kurone741/tamago/README.md

# tamago

tamago is a simple desktop companion. I built it because I thought it seemed like a good entry point into pcb design, without being unnecessarily complex. 

Functionality includes date/time, timer, stopwatch, countdown, and noise visualizer which responds to the sounds in your working space (e.g. typing/music). It can also display humidity and temperature of your working space. It's a device that is for the most part single-purpose, meaning it doesn't occupy more of your attention than it needs. THis also helps me stay on focus more.

ps. tamago is japanese for egg

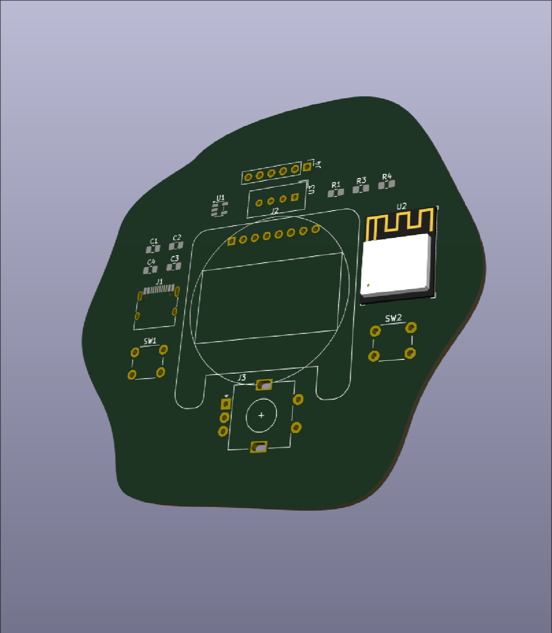
[picture p1: images/tamago-unrouted-pcb-3d.png]
tamago unrouted pcb 3d

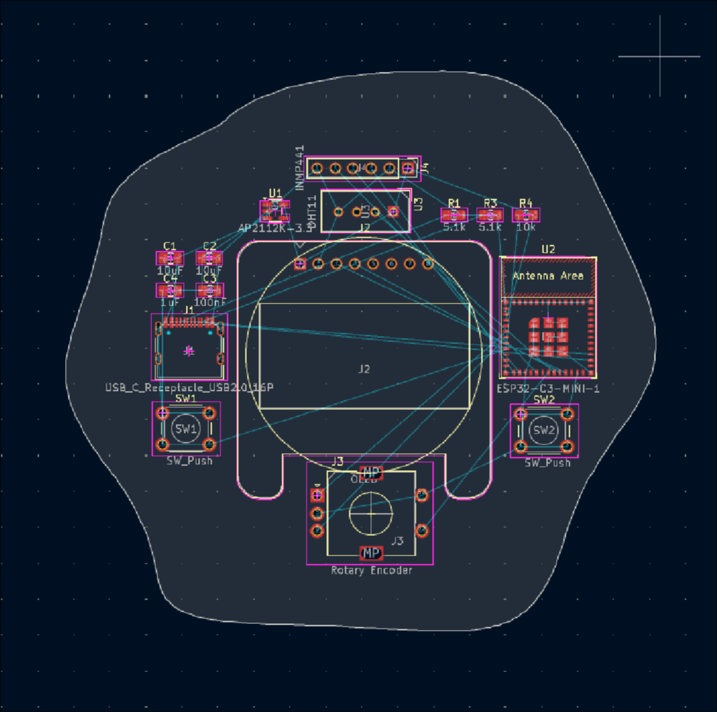
[picture p2: tamago-unrouted-pcb.png]
unrouted pcb diagram

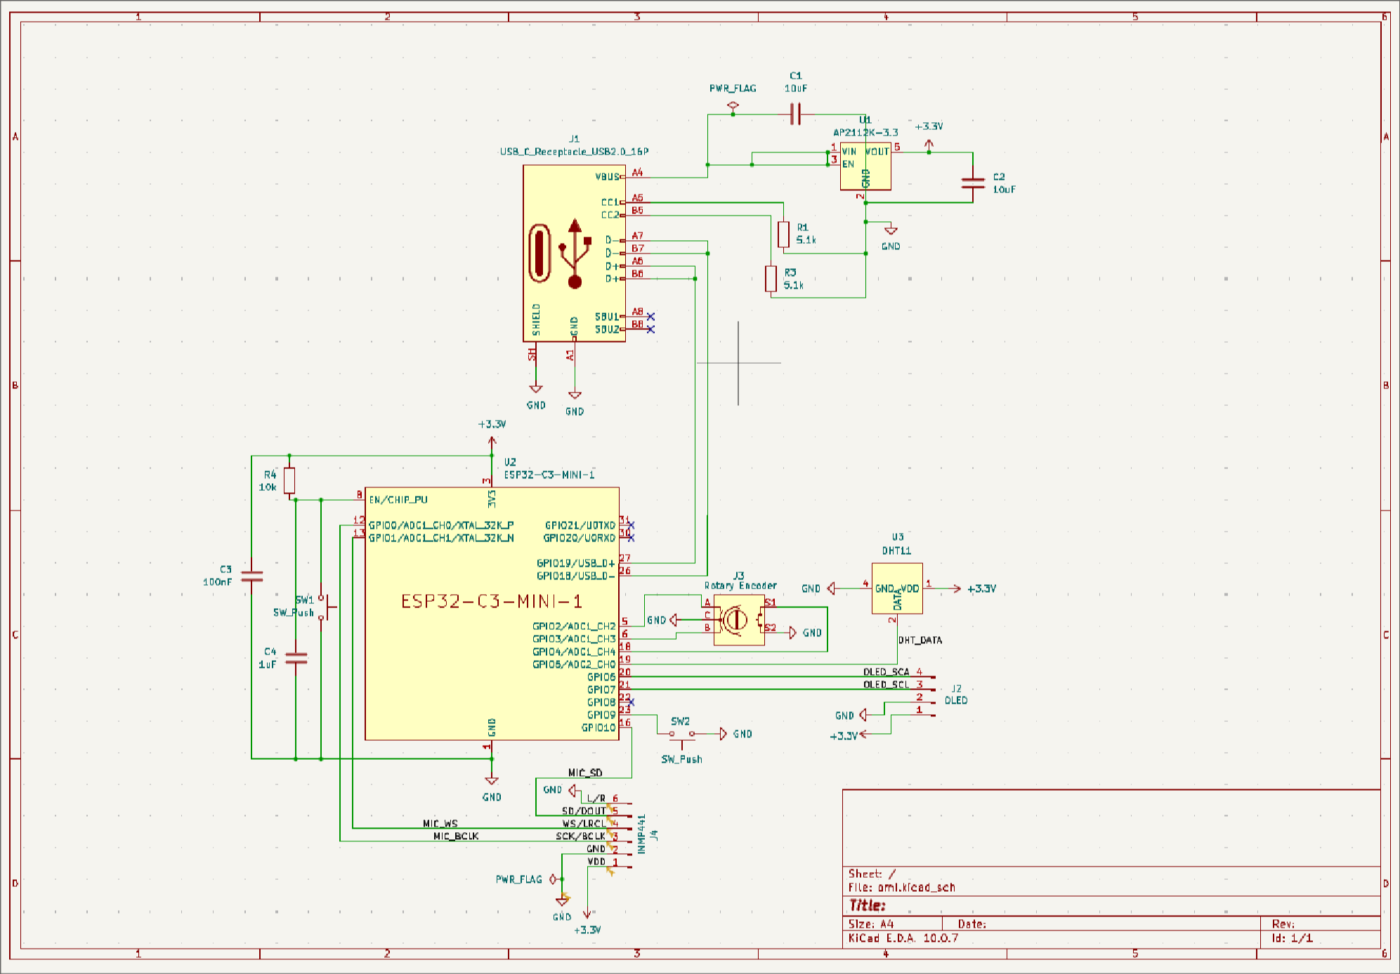
[picture p3: images/tamago-schematic-finished.png]
tamago schematic finished!


## bill of materials
| Item | Qty | Supplier | Cost/item | Total Cost | Link |
|---|---:|---|---:|---:|---|
| ESP32-C3-MINI-1 | 1 | Aliexpress | $4.69 | $4.69 | https://www.aliexpress.com/item/3256810385497528.html |
| 0.96" OLED | 1 | Aliexpress | $1.09 | $1.09 | https://www.aliexpress.com/item/3256810476428595.html |
| EC11 KY-040 Rotary Encoder | 1 | Aliexpress | $2.49 | $2.49 | https://www.aliexpress.com/item/3256812187820082.html |
| DHT11 | 1 | Aliexpress | $2.01 | $2.01 | https://www.aliexpress.com/item/3256808804649487.html |
| INMP441 | 1 | Aliexpress | $2.95 | $2.95 | https://www.aliexpress.com/item/3256809519855925.html |
| Passive Components | 1 | Aliexpress | $12.27 | $12.27 | https://www.aliexpress.us/item/3256803146822180.html |
| PCB | 1 | JLCPCB | $4.00 | $4.00 | https://jlcpcb.com |
| Estimated total shipping | 1 | | | $0.00 | |
