kurone741/tamago/errormessage.png

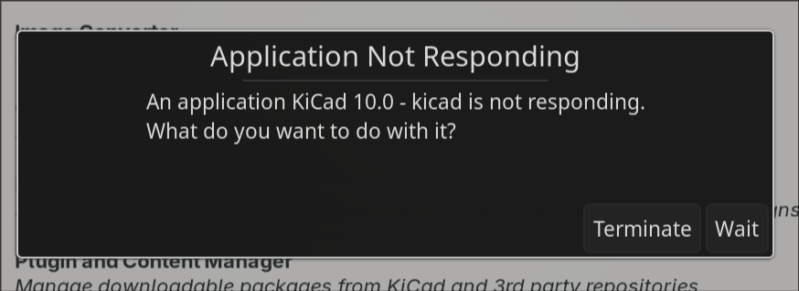
errormessage.png
