kurone741/tamago/finishedp1.png

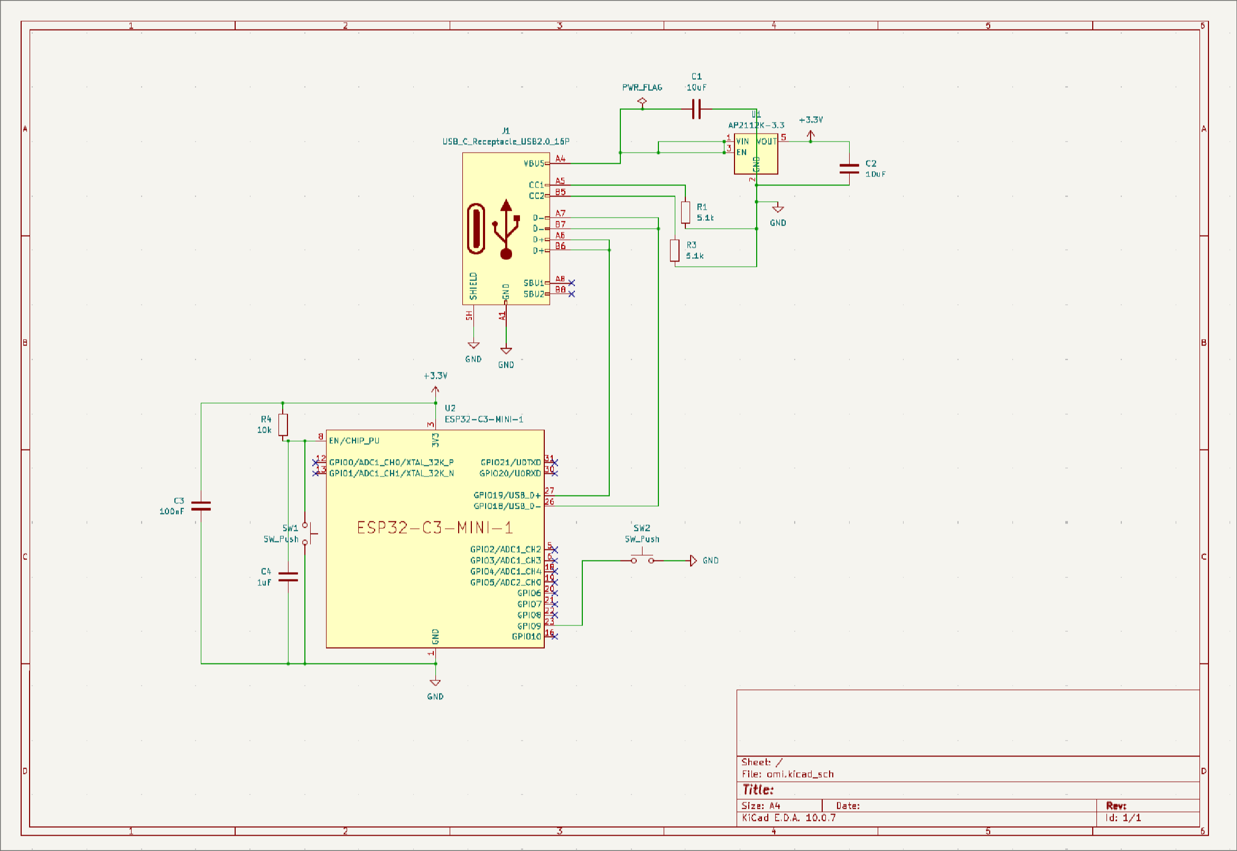
finishedp1.png
