kurone741/tamago/footprints.png

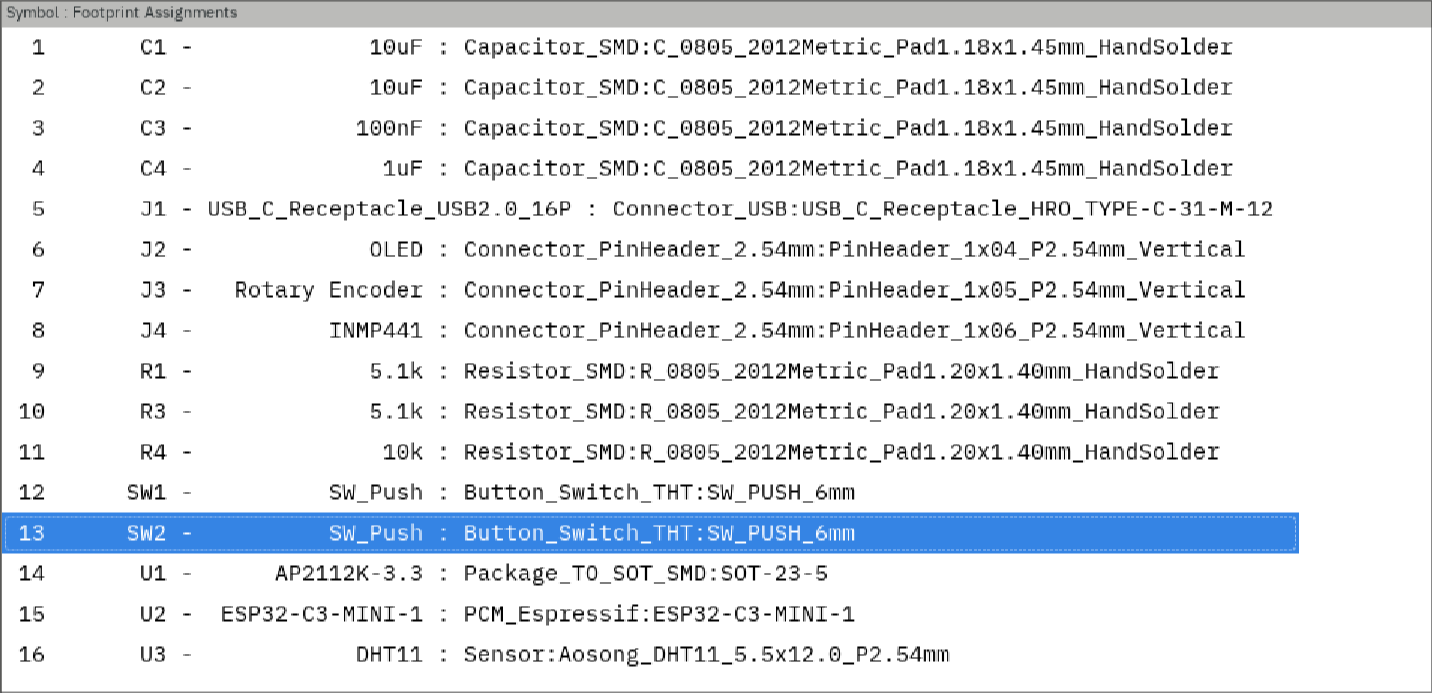
footprints.png
