kurone741/tamago/messy-schematic.png

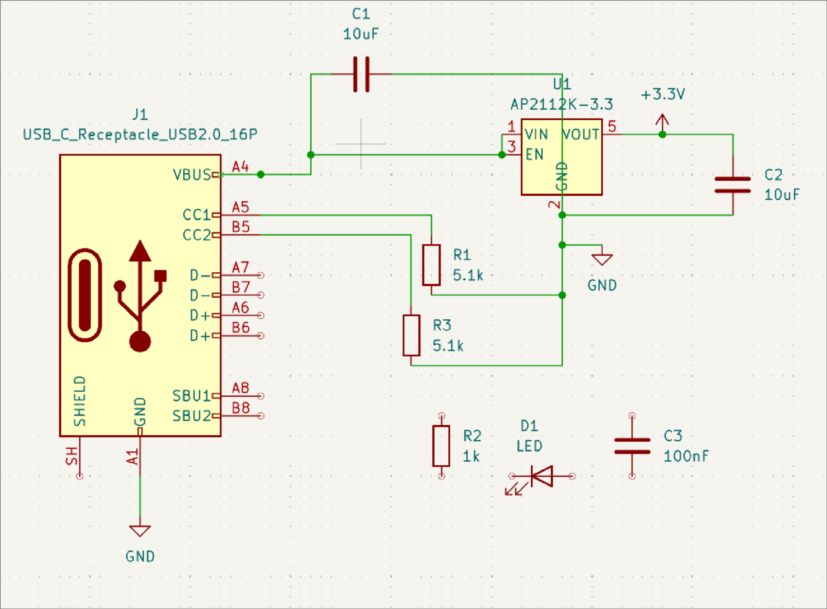
messy-schematic.png
