kurone741/tamago/schematic-tamago.png

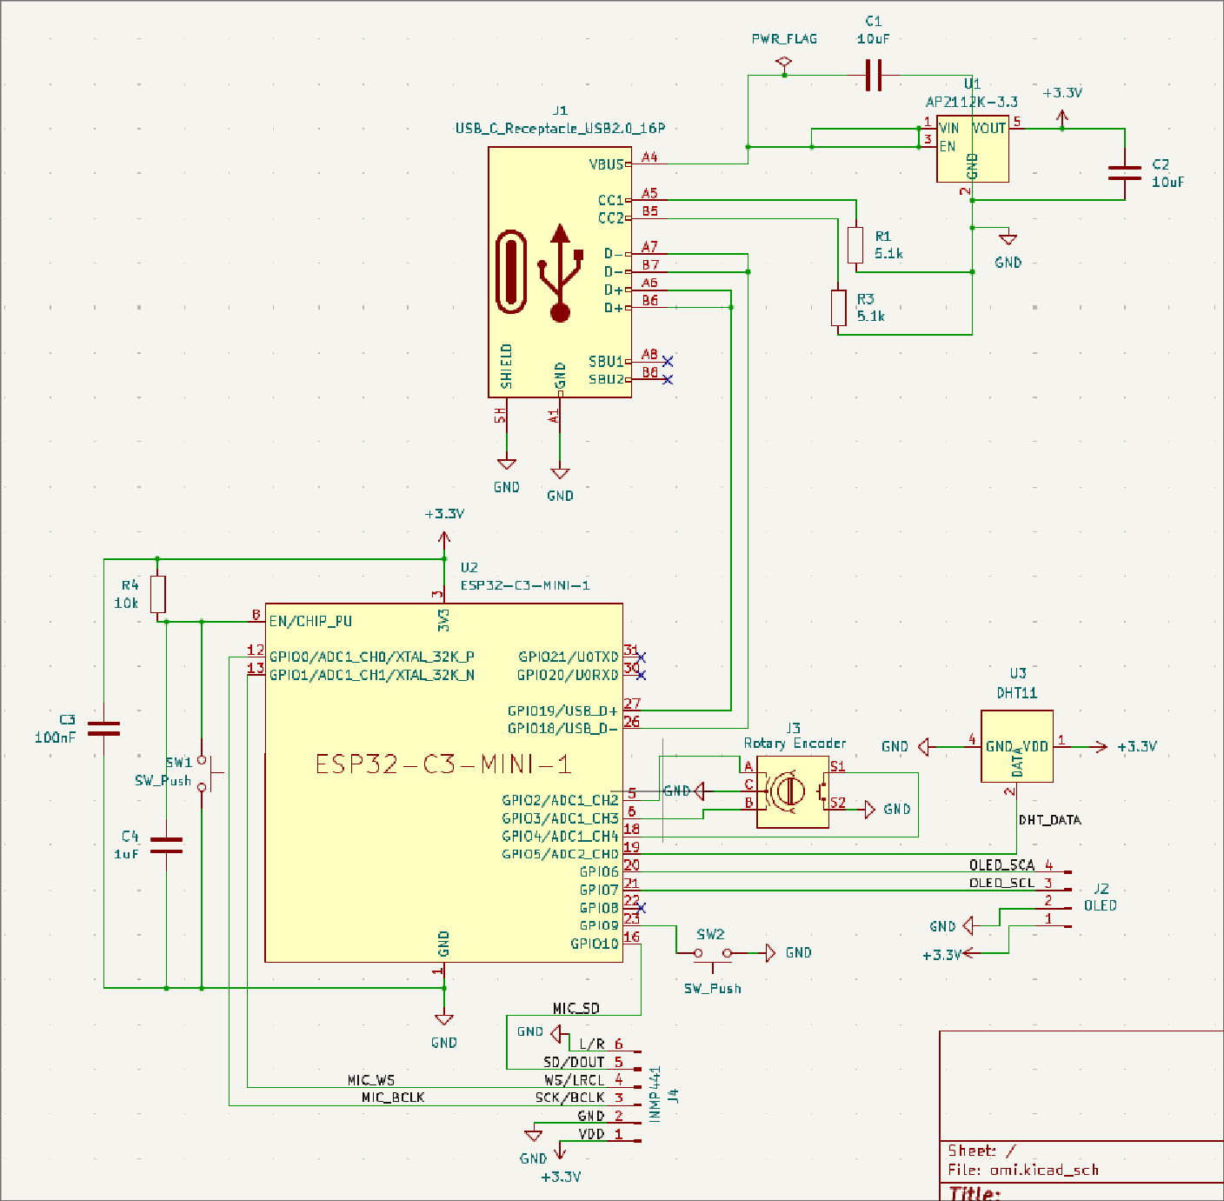
schematic-tamago.png
