kurone741/tamago/BOM.md

# tamago – bill of materials

<!-- Generated by Half Life from project cmuvo6hr3017j01o9qqlkuulm. Edits here are overwritten on the next sync. -->
<!-- Generated: 2026-10-07T18:07:17.455Z -->

> [!NOTE]
> This parts list is mirrored from [Half Life](https://halflife.hackclub.com). Editing it here will not change the platform's copy, and the next sync overwrites this file.

| Week | Tier | Parts funding |
| --- | --- | --- |
| Week 1 | Tier 1 | $30.00 |

| Part | What it's for | Qty | Unit | Total | Vendor |
| --- | --- | --- | --- | --- | --- |
| [ESP32-C3](https://www.seeedstudio.com/Seeed-XIAO-ESP32C3-p-5431.html) | Microcontroller Unit | 1 | $5.00 | $5.00 | [Seeed Studio](https://www.seeedstudio.com/Seeed-XIAO-ESP32C3-p-5431.html) |
| [0.96" OLED](https://lilygo.cc/en-us/products/0-96-inch-oled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) | Display | 1 | $2.50 | $2.50 | [LilyGo](https://lilygo.cc/en-us/products/0-96-inch-oled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) |
| [DHT11](https://www.adafruit.com/product/386?srsltid=AU7gw4UjzMGeLMIzODNCHf76YzeZTfT2tLIA2TnPeSra5yNevl4yPcj8) | Temperature/Humidity Sensor | 1 | $5.00 | $5.00 | [Adafruit](https://www.adafruit.com/product/386?srsltid=AU7gw4UjzMGeLMIzODNCHf76YzeZTfT2tLIA2TnPeSra5yNevl4yPcj8) |
| [PCB](https://jlcpcb.com) | Circuit Board | 1 | $10.00 | $10.00 | [JLCPCB](https://jlcpcb.com) |
| [10k Resistor](https://www.jameco.com/z/CF1W103JRC-Jameco-ValuePro-Resistor-Carbon-Film-10k-Ohm-1-Watt-5-_2237221.html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) | Resistor | 1 | $0.14 | $0.14 | [Jameco](https://www.jameco.com/z/CF1W103JRC-Jameco-ValuePro-Resistor-Carbon-Film-10k-Ohm-1-Watt-5-_2237221.html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) |
| **Parts subtotal** | — | — | — | **$22.64** | — |
| **Tax & shipping** | — | — | — | **$0.00** | — |
| **Total** | — | — | — | **$22.64** | — |

$7.36 left of the tier's funding.
