kurone741/tamago/BOM.csv

Item | Qty | Supplier | Cost/item | Total Cost | link
ESP32-C3-MINI-1 | 1 | Aliexpress | $4.69 | $4.69 | https://www.aliexpress.com/item/3256810385497528.html?mp=1
0.96" OLED | 1 | Aliexpress | $1.09 | $1.09 | https://www.aliexpress.com/item/3256810476428595.html?mp=1
EC11 KY-040 Rotary Encoder | 1 | Aliexpress | $2.49 | $2.49 | https://www.aliexpress.com/item/3256812187820082.html?mp=1
DHT11 | 1 | Aliexpress | $2.01 | $2.01 | https://www.aliexpress.com/item/3256808804649487.html?mp=1
INMP441 | 1 | Aliexpress | $2.95 | $2.95 | https://www.aliexpress.com/item/3256809519855925.html?mp=1
Passive Components | 1 | Aliexpress | $12.27 | $12.27 | https://www.aliexpress.us/item/3256803146822180.html?curPageLogUid=lsZQEkA5xBuk
PCB | 1 | JLCPCB | $4.00 | $4.00 | https://jlcpcb.com
Estimated total shipping | 1 |  |  | $0.00
