kurone741/tamago/debugging-erc-errors.png

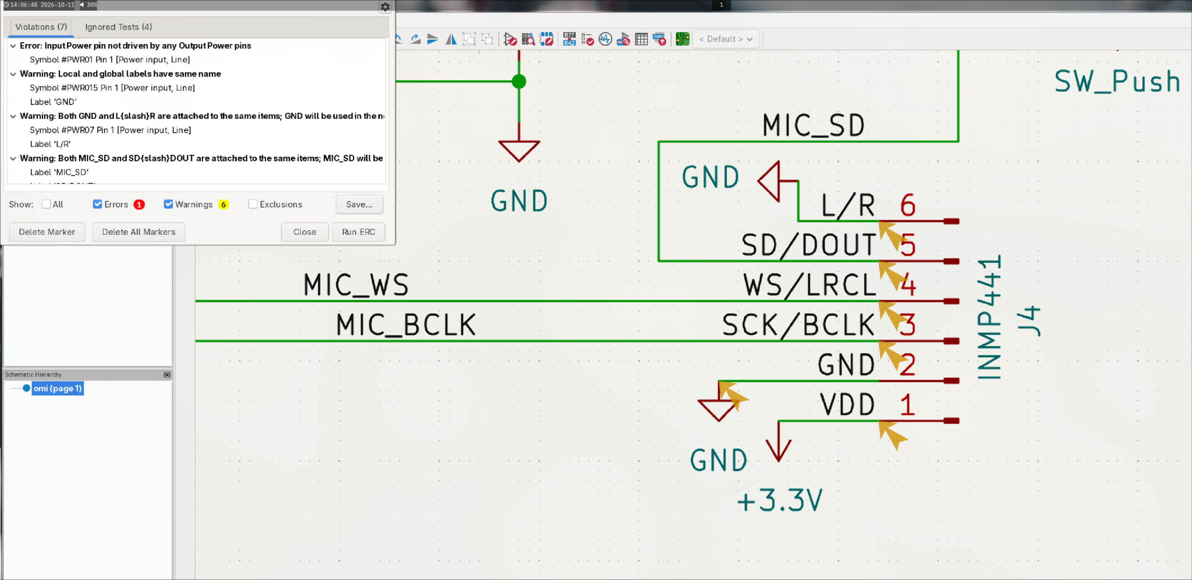
debugging-erc-errors.png
