kurone741/tamago/pcb/tamago.kicad_pcb

## KiCad design pcb/tamago.kicad_pcb (2026-10-21)

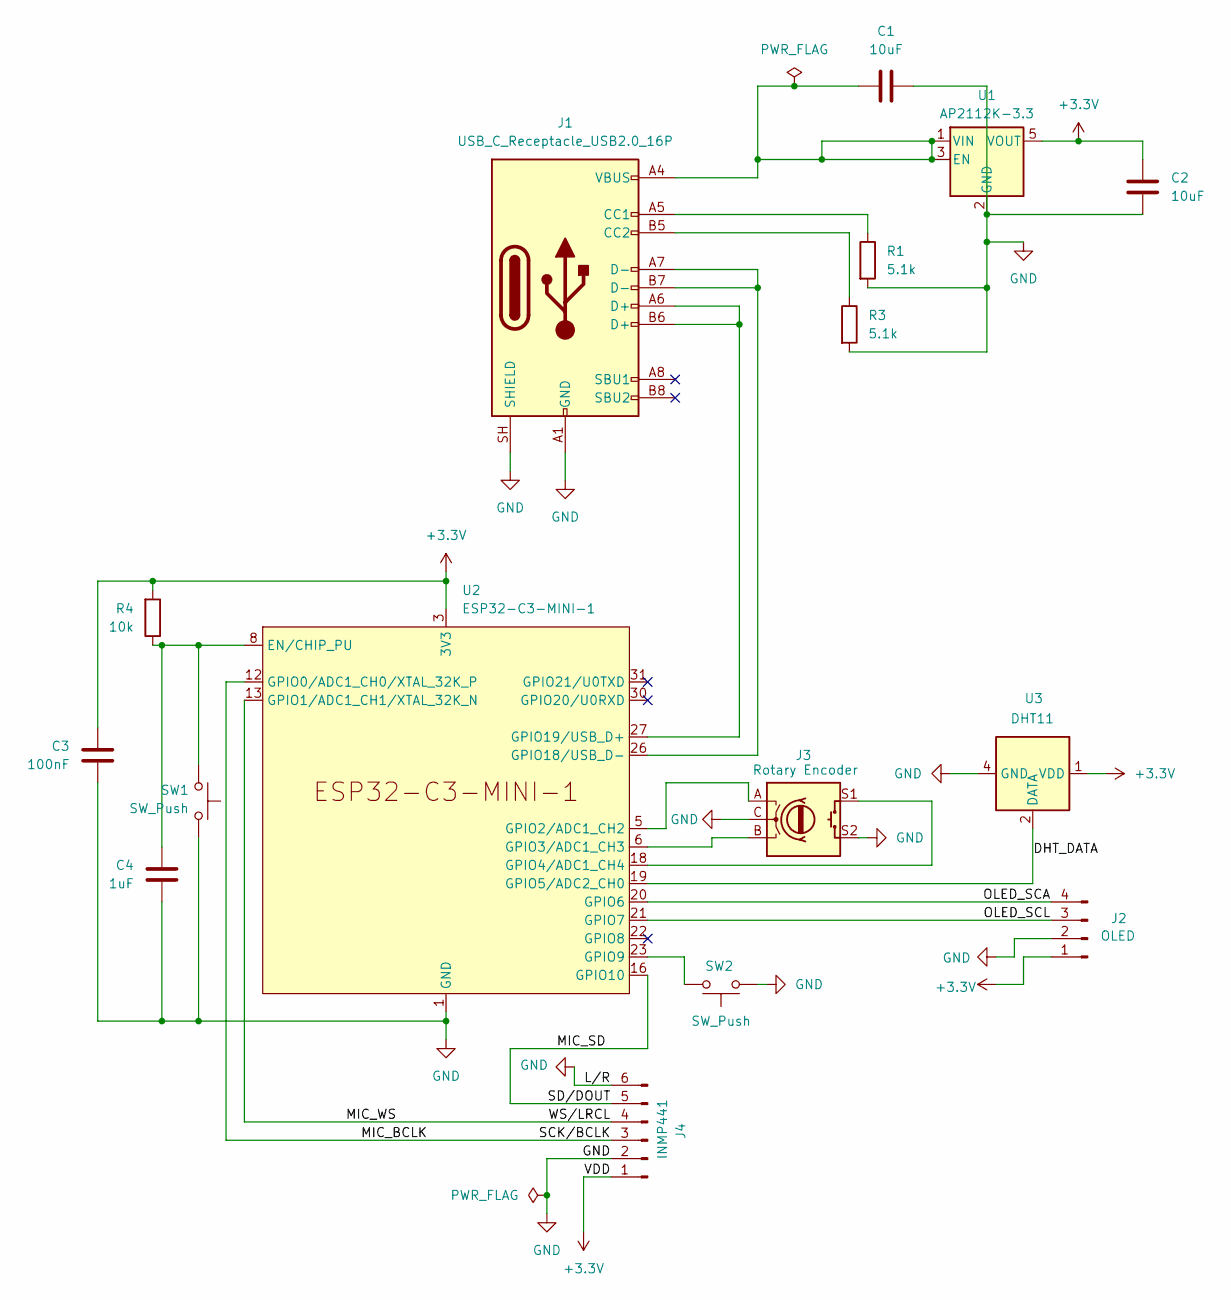
[picture p10: schematic tamago.kicad_sch]

Parts:
C1, C2: 10uF; C_0805_2012Metric_Pad1.18x1.45mm_HandSolder
C3: 100nF; C_0805_2012Metric_Pad1.18x1.45mm_HandSolder
C4: 1uF; C_0805_2012Metric_Pad1.18x1.45mm_HandSolder
J1: USB_C_Receptacle_USB2.0_16P; USB_C_Receptacle_HRO_TYPE-C-31-M-12
J2: OLED; Adafruit_SSD1306_No_Mounting_Holes
J3: Rotary Encoder; RotaryEncoder_Alps_EC11E-Switch_Vertical_H20mm
J4: INMP441; PinHeader_1x06_P2.54mm_Vertical
R1, R3: 5.1k; R_0805_2012Metric_Pad1.20x1.40mm_HandSolder
R4: 10k; R_0805_2012Metric_Pad1.20x1.40mm_HandSolder
SW1, SW2: SW_Push; SW_PUSH_6mm
U1: AP2112K-3.3; SOT-23-5
U2: ESP32-C3-MINI-1
U3: DHT11; Aosong_DHT11_5.5x12.0_P2.54mm

Connections:
+3.3V: C2.1, C3.1, J2.1, J4.1, R4.2, U1.5 (VOUT), U2.3 (3V3), U3.1 (VDD)
/DHT_DATA: U2.19 (GPIO5/ADC2_CH0), U3.2 (DATA)
/MIC_BCLK: J4.3, U2.12 (GPIO0/ADC1_CH0/XTAL_32K_P)
/MIC_SD: J4.5, U2.16 (GPIO10)
/MIC_WS: J4.4, U2.13 (GPIO1/ADC1_CH1/XTAL_32K_N)
/OLED_SCA: J2.4, U2.20 (GPIO6)
/OLED_SCL: J2.3, U2.21 (GPIO7)
GND: C1.1, C2.2, C3.2, C4.2, J1.A1 (GND), J1.A12 (GND), J1.B1 (GND), J1.B12 (GND), J1.SH (SHIELD), J2.2, J3.C, J3.S2, J4.2, J4.6, R1.2, R3.2, SW1.1, SW2.2, U1.2 (GND), U2.1 (GND), U2.2 (GND), U2.11 (GND), U2.14 (GND), U2.36 (GND), U2.37 (GND), U2.38 (GND), U2.39 (GND), U2.40 (GND), U2.41 (GND), U2.42 (GND), U2.43 (GND), U2.44 (GND), U2.45 (GND), U2.46 (GND), U2.47 (GND), U2.48 (GND), U2.49 (GND), U2.50 (GND), U2.51 (GND), U2.52 (GND), U2.53 (GND), U3.4 (GND)
unnamed: J1.A5 (CC1), R1.1
unnamed: J1.B5 (CC2), R3.1
unnamed: C1.2, J1.A4 (VBUS), J1.A9 (VBUS), J1.B4 (VBUS), J1.B9 (VBUS), U1.1 (VIN), U1.3 (EN)
unnamed: C4.1, R4.1, SW1.2, U2.8 (EN/CHIP_PU)
unnamed: J3.A, U2.5 (GPIO2/ADC1_CH2)
unnamed: J3.B, U2.6 (GPIO3/ADC1_CH3)
unnamed: J3.S1, U2.18 (GPIO4/ADC1_CH4)
unnamed: SW2.1, U2.23 (GPIO9)
unnamed: J1.A7 (D-), J1.B7 (D-), U2.26 (GPIO18/USB_D-)
unnamed: J1.A6 (D+), J1.B6 (D+), U2.27 (GPIO19/USB_D+)

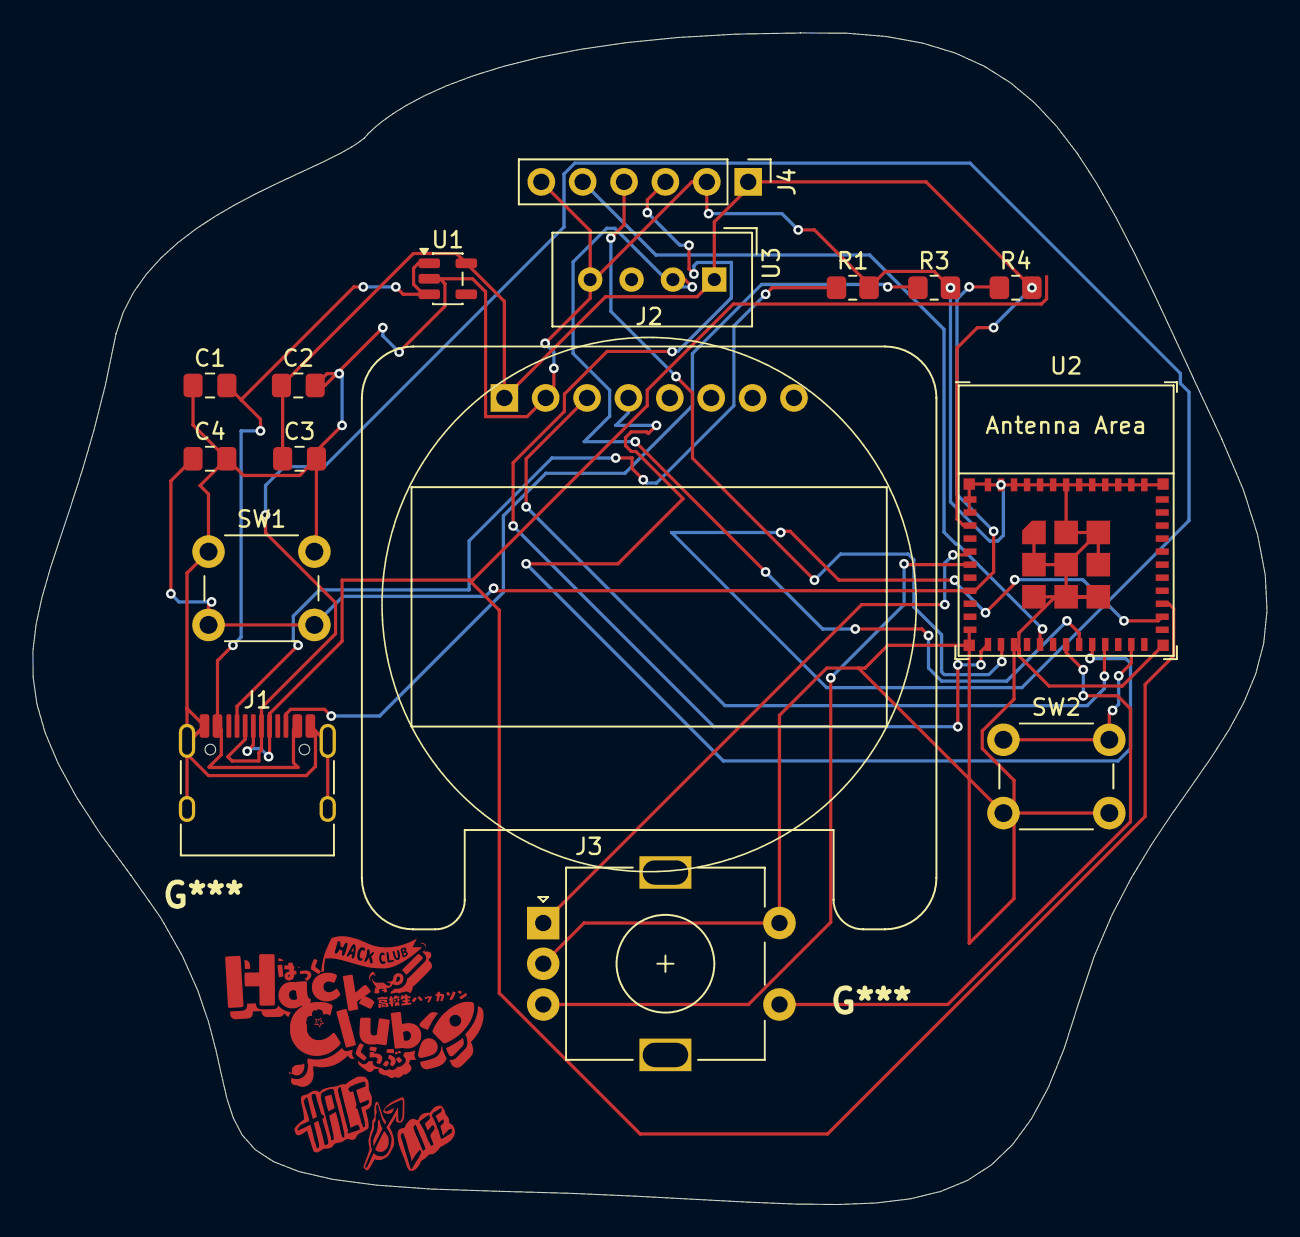
[picture p11: board tamago.kicad_pcb from above]

Board: 2 copper layers, 75.8 x 71.9 mm, 16 parts (0 on the bottom side), 18 nets.
