kurone741/tamago/(commit log)

2026-10-11 finished schematic
2026-10-11 updated pcb ss
2026-10-12 finished pcb
2026-10-12 pcb art
2026-10-12 new pcb art
2026-10-21 added bom to readme
